Forest-S/Jishupro/CAD/figure_1.png

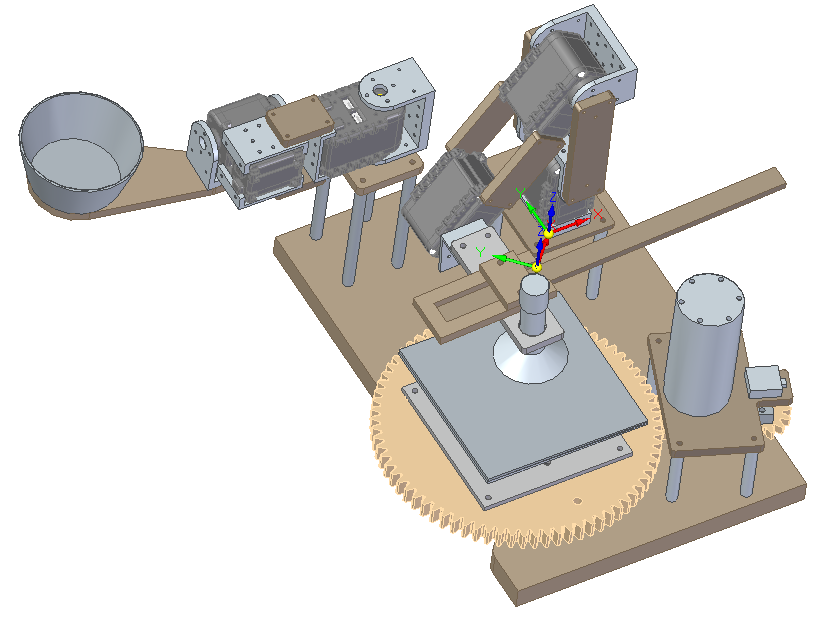
CAD/figure_1.png
