Forest-S/Jishupro/CAD/figure_2.png

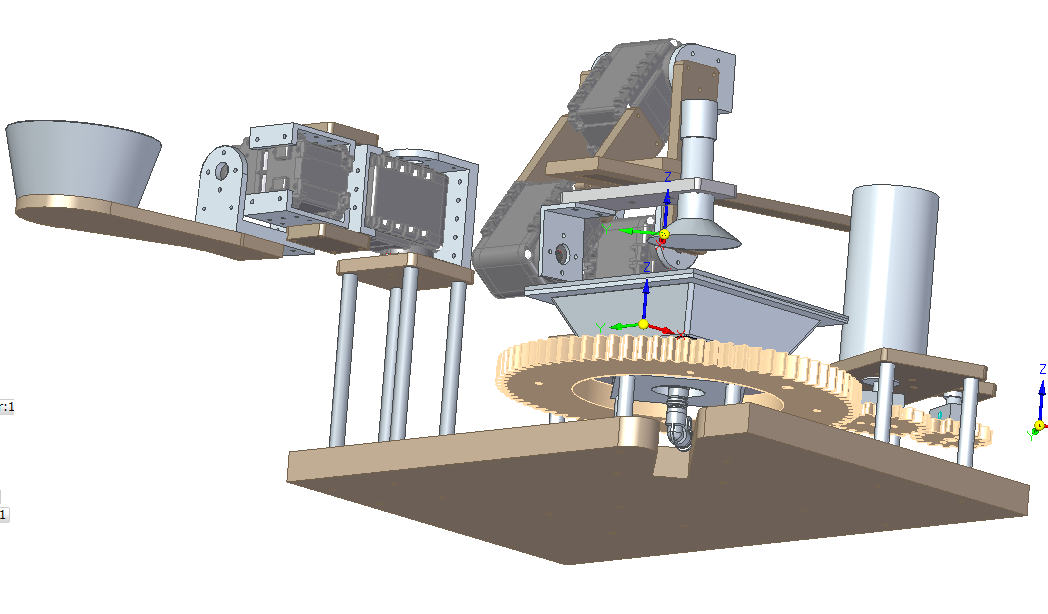
CAD/figure_2.png
