Forest-S/Jishupro/CAD/figure_4.png

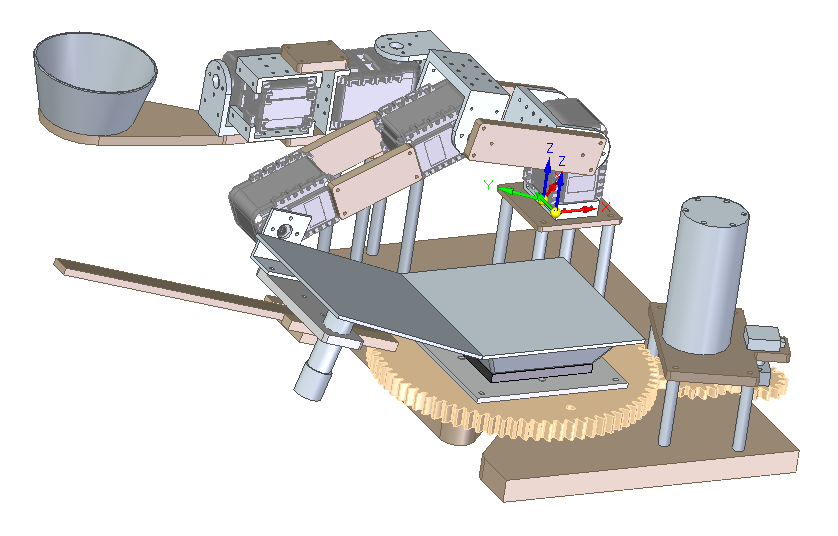
CAD/figure_4.png
