Forest-S/Jishupro/CAD/figure_5.png

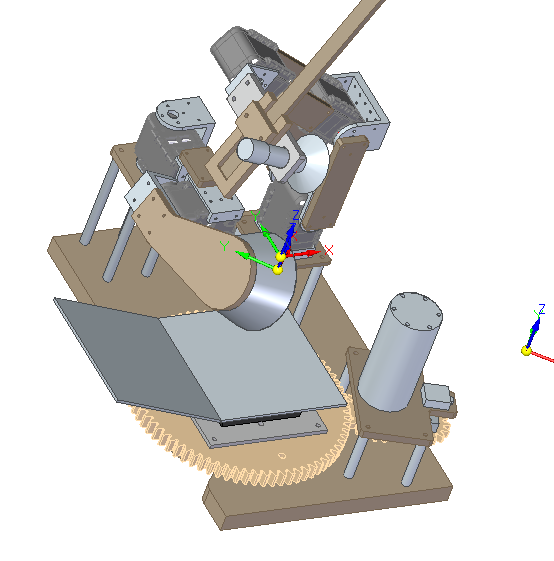
CAD/figure_5.png
