Forest-S/Jishupro/CAD/figure_6.png

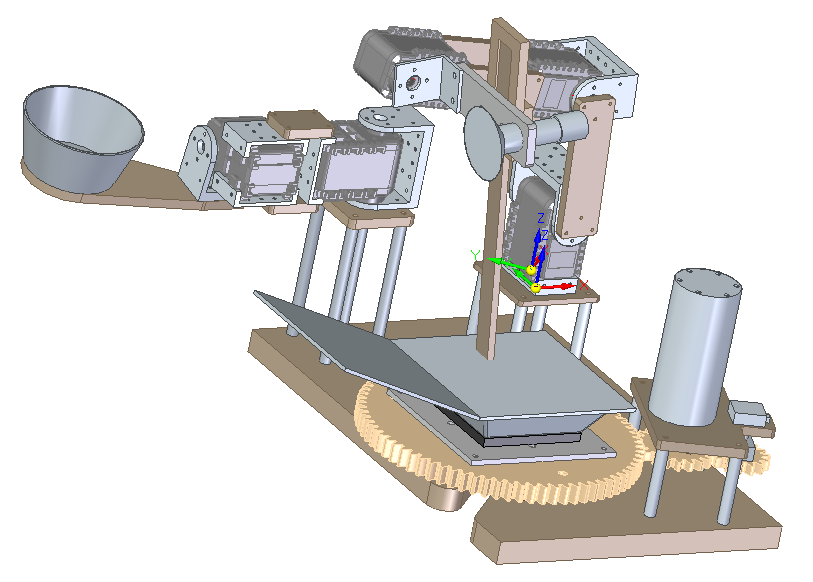
CAD/figure_6.png
