Forest-S/Jishupro/CAD/fiugre_3.png

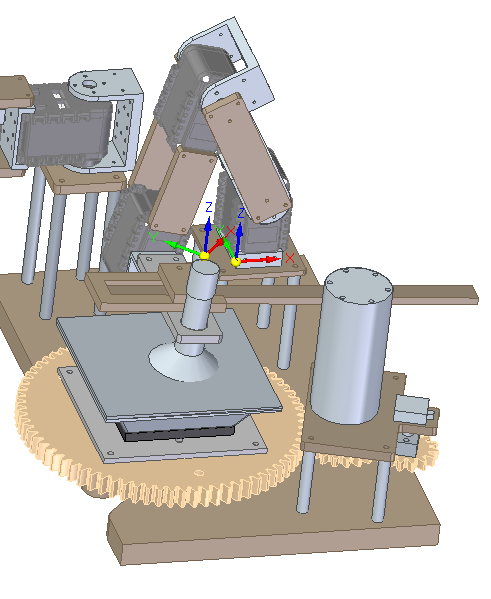
CAD/fiugre_3.png
