Forest-S/Jishupro/CAD/arm/AX-Aseries_3D_IGS/AX-12A.igs

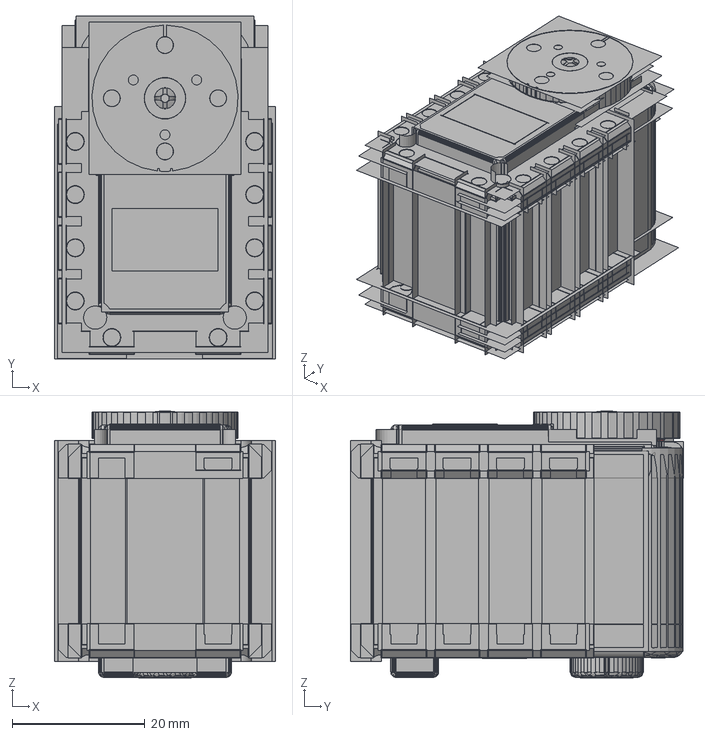
[picture p19: CAD file, 2016-01-23]
CAD/arm/AX-Aseries_3D_IGS/AX-12A.igs
33.3 x 51.6 x 40.1 mm
