Forest-S/Jishupro/CAD/base/PV4M.stp

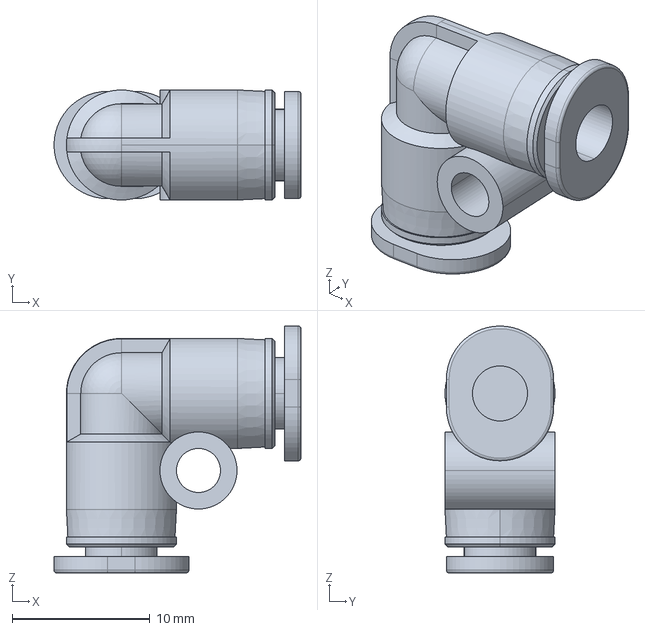
[picture p20: CAD file, 2016-01-23]
CAD/base/PV4M.stp
18.0 x 8.00 x 18.0 mm
