Forest-S/Jishupro/CAD/base/PC4-M5M.stp

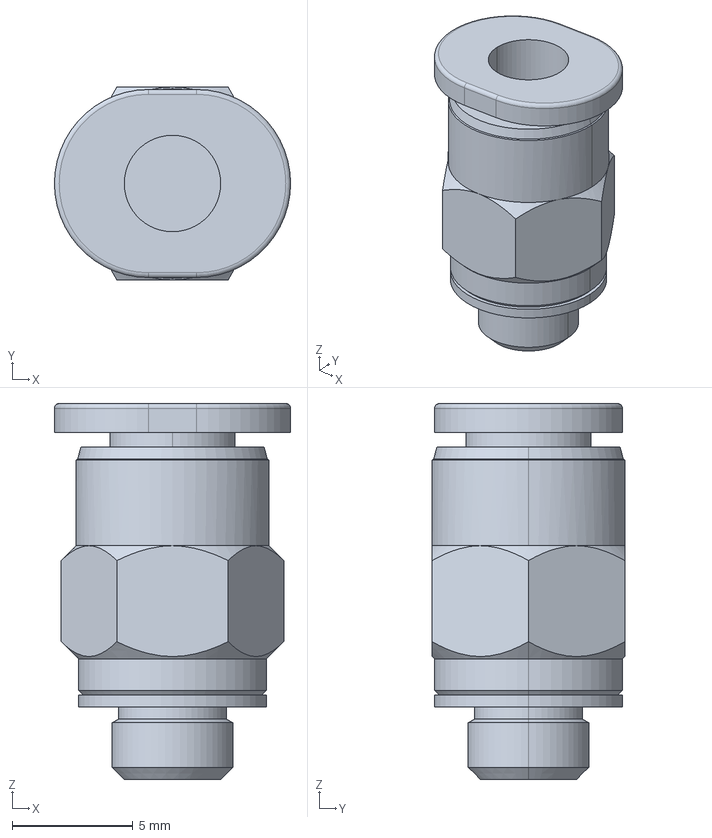
[picture p21: CAD file, 2016-01-23]
CAD/base/PC4-M5M.stp
9.80 x 8.00 x 15.6 mm
